hpcis/precision-irrigation/assets/images/irrigation-box-finished-transparent.png

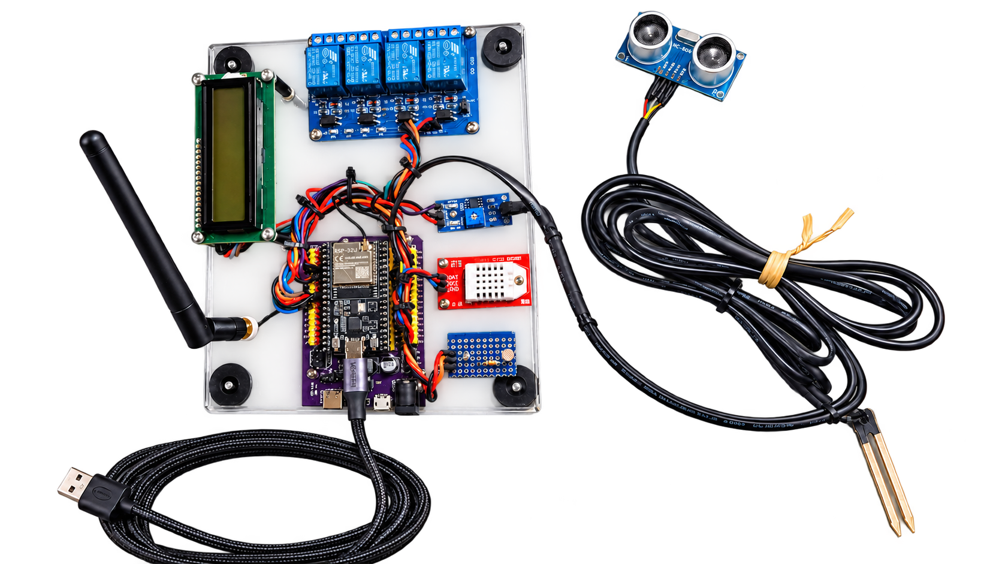
assets/images/irrigation-box-finished-transparent.png
