hpcis/precision-irrigation/(commit log)

2026-09-24 Add ESP32 irrigation tutorial and diagrams
2026-09-27 Add Arduino libraries
2026-09-27 Clarify Blynk relay and datastream mapping
